Quard/7clock/hardware/7clock.kicad_pcb

## KiCad design hardware/7clock.kicad_pcb (2024-10-06)

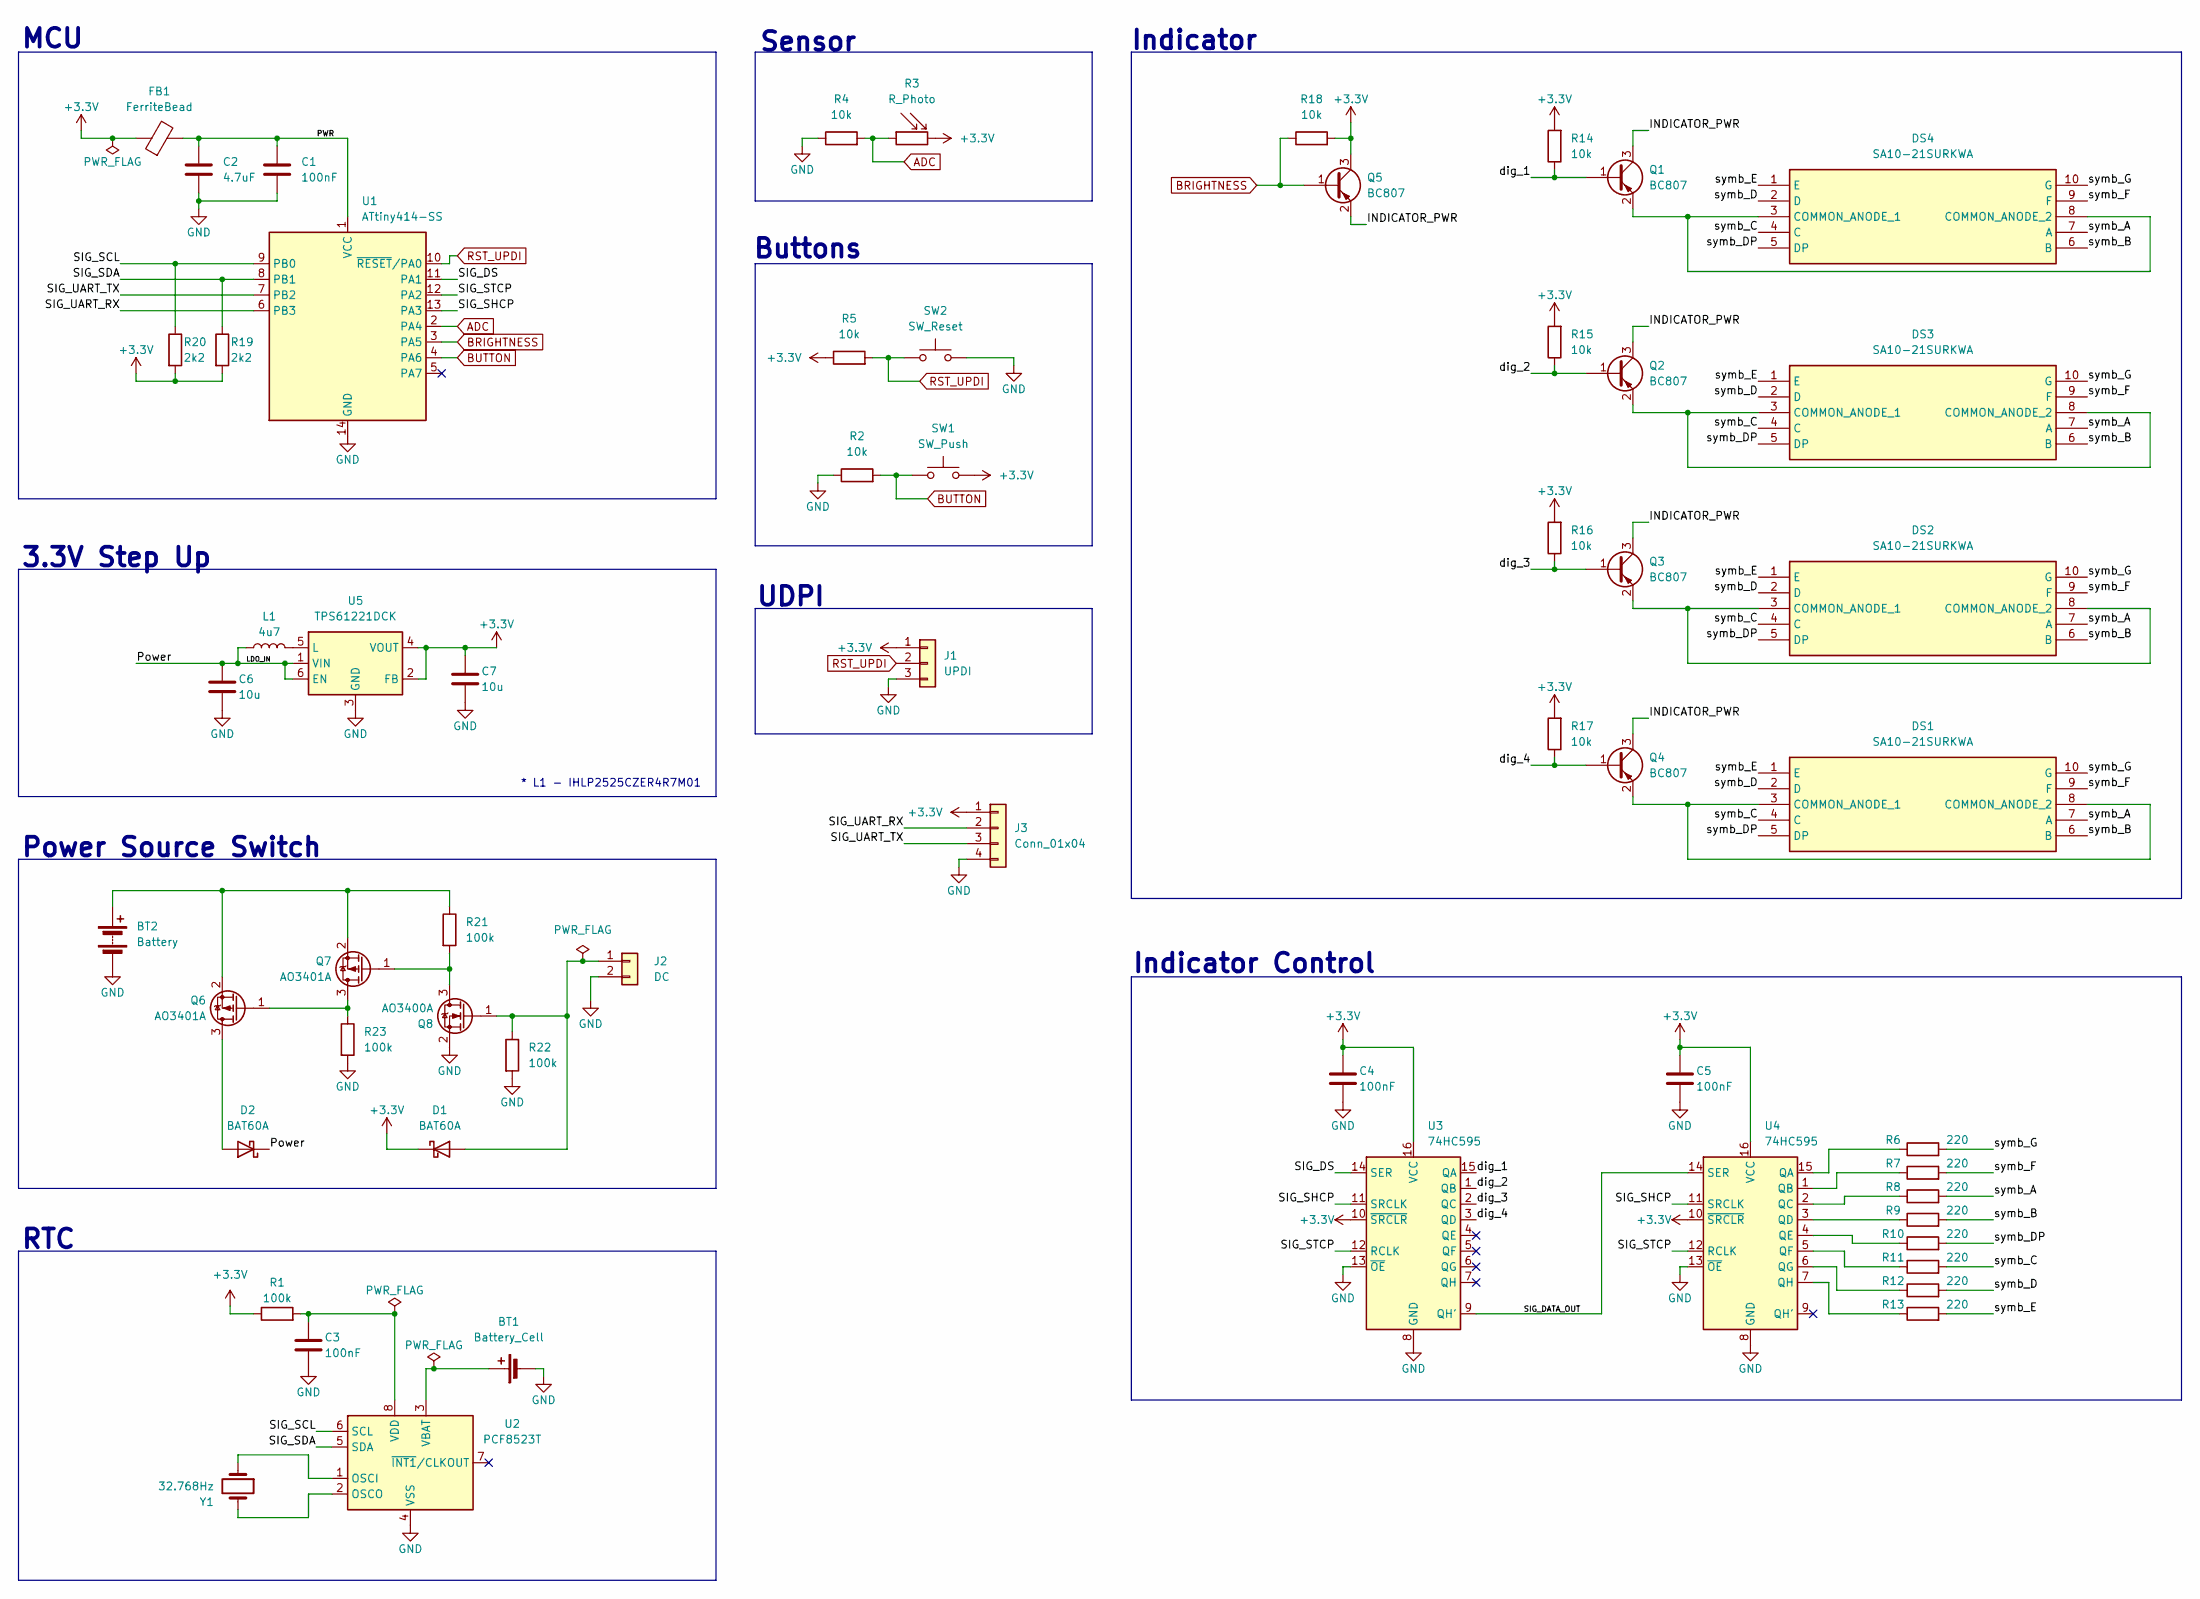
[picture p1: schematic 7clock.kicad_sch]

Parts:
BT1: Battery_Cell; CR1220D-011
BT2: Battery; PinHeader_1x02_P2.54mm_Vertical
C1, C3, C4, C5: 100nF; C_0603_1608Metric
C2: 4.7uF; C_0805_2012Metric
C6, C7: 10u; C_0805_2012Metric
D1, D2: BAT60A; D_SOD-323
DS1, DS2, DS3, DS4: SA10-21SURKWA; DIP3040W75P254L2400H1050Q10N; Manufacturer_Part_Number SA10-21SURKWA; Mouser Part Number 604-SA10-21SURKWA
FB1: FerriteBead; L_0603_1608Metric
J1: UPDI; PinHeader_1x03_P2.54mm_Vertical
J2: DC; PinHeader_1x02_P2.54mm_Vertical
J3: Conn_01x04; PinHeader_1x04_P2.54mm_Vertical
L1: 4u7; L_Vishay_IHLP-2525
Q1, Q2, Q3, Q4, Q5: BC807; SOT-23
Q6, Q7: AO3401A; SOT-23
Q8: AO3400A; SOT-23
R1, R21, R22, R23: 100k; R_0603_1608Metric
R2, R4, R5, R14, R15, R16, R17, R18: 10k; R_0603_1608Metric
R3: R_Photo; PinHeader_1x02_P2.54mm_Vertical
R6, R7, R8, R9, R10, R11, R12, R13: 220; R_0603_1608Metric
R19, R20: 2k2; R_0603_1608Metric
SW1: SW_Push; SW_SPST_SKQG_WithoutStem
SW2: SW_Reset; SW_SPST_CK_RS282G05A3
U1: ATtiny414-SS; SOIC-14_3.9x8.7mm_P1.27mm
U2: PCF8523T; SOIC-8_3.9x4.9mm_P1.27mm
U3, U4: 74HC595; SO-16_3.9x9.9mm_P1.27mm
U5: TPS61221DCK; Texas_R-PDSO-G6
Y1: 32.768Hz; Crystal_C38-LF_D3.0mm_L8.0mm_Horizontal

Connections:
+3.3V: C4.1, C5.1, C7.1, D1.1 (K), FB1.1, J1.1, J3.1, Q5.3 (C), R1.1, R3.2, R5.1, R14.2, R15.2, R16.2, R17.2, R18.2, R19.2, R20.2, SW1.2, U3.10 (~SRCLR), U3.16 (VCC), U4.10 (~SRCLR), U4.16 (VCC), U5.2 (FB), U5.4 (VOUT)
/INDICATOR_PWR: Q1.3 (C), Q2.3 (C), Q3.3 (C), Q4.3 (C), Q5.2 (E)
/LDO_IN: C6.1, D2.1 (K), L1.1, U5.1 (VIN), U5.6 (EN)
/PWR: C1.1, C2.1, FB1.2, U1.1 (VCC)
/SIG_DATA_OUT: U3.9 (QH'), U4.14 (SER)
/SIG_DS: U1.11 (PA1), U3.14 (SER)
/SIG_SCL: R20.1, U1.9 (PB0), U2.6 (SCL)
/SIG_SDA: R19.1, U1.8 (PB1), U2.5 (SDA)
/SIG_SHCP: U1.13 (PA3), U3.11 (SRCLK), U4.11 (SRCLK)
/SIG_STCP: U1.12 (PA2), U3.12 (RCLK), U4.12 (RCLK)
/SIG_UART_RX: J3.2, U1.6 (PB3)
/SIG_UART_TX: J3.3, U1.7 (PB2)
/dig_1: Q1.1 (B), R14.1, U3.15 (QA)
/dig_2: Q2.1 (B), R15.1, U3.1 (QB)
/dig_3: Q3.1 (B), R16.1, U3.2 (QC)
/dig_4: Q4.1 (B), R17.1, U3.3 (QD)
/symb_A: DS1.7 (A), DS2.7 (A), DS3.7 (A), DS4.7 (A), R8.2
/symb_B: DS1.6 (B), DS2.6 (B), DS3.6 (B), DS4.6 (B), R9.2
/symb_C: DS1.4 (C), DS2.4 (C), DS3.4 (C), DS4.4 (C), R11.2
/symb_D: DS1.2 (D), DS2.2 (D), DS3.2 (D), DS4.2 (D), R12.2
/symb_DP: DS1.5 (DP), DS2.5 (DP), DS3.5 (DP), DS4.5 (DP), R10.2
/symb_E: DS1.1 (E), DS2.1 (E), DS3.1 (E), DS4.1 (E), R13.2
/symb_F: DS1.9 (F), DS2.9 (F), DS3.9 (F), DS4.9 (F), R7.2
/symb_G: DS1.10 (G), DS2.10 (G), DS3.10 (G), DS4.10 (G), R6.2
ADC: R3.1, R4.2, U1.2 (PA4)
BRIGHTNESS: Q5.1 (B), R18.1, U1.3 (PA5)
BUTTON: R2.2, SW1.1, U1.4 (PA6)
GND: BT1.2 (-), BT2.2 (-), C1.2, C2.2, C3.2, C4.2, C5.2, C6.2, C7.2, J1.3, J2.2, J3.4, Q8.2 (S), R2.1, R4.1, R22.2, R23.2, SW2.2, U1.14 (GND), U2.4 (VSS), U3.8 (GND), U3.13 (~OE), U4.8 (GND), U4.13 (~OE), U5.3 (GND)
unnamed: BT1.1 (+), U2.3 (VBAT)
unnamed: BT2.1 (+), Q6.2 (S), Q7.2 (S), R21.1
unnamed: D1.2 (A), J2.1, Q8.1 (G), R22.1
unnamed: D2.2 (A), Q6.3 (D)
unnamed: DS1.3 (COMMON_ANODE_1), DS1.8 (COMMON_ANODE_2), Q4.2 (E)
unnamed: DS2.3 (COMMON_ANODE_1), DS2.8 (COMMON_ANODE_2), Q3.2 (E)
unnamed: DS3.3 (COMMON_ANODE_1), DS3.8 (COMMON_ANODE_2), Q2.2 (E)
unnamed: DS4.3 (COMMON_ANODE_1), DS4.8 (COMMON_ANODE_2), Q1.2 (E)
unnamed: Q6.1 (G), Q7.3 (D), R23.1
unnamed: Q7.1 (G), Q8.3 (D), R21.2
unnamed: U2.1 (OSCI), Y1.1
unnamed: U2.2 (OSCO), Y1.2
unnamed: C3.1, R1.2, U2.8 (VDD)
unnamed: R6.1, U4.15 (QA)
unnamed: R7.1, U4.1 (QB)
unnamed: R8.1, U4.2 (QC)
unnamed: R9.1, U4.3 (QD)
unnamed: R10.1, U4.4 (QE)
unnamed: R11.1, U4.5 (QF)
unnamed: R12.1, U4.6 (QG)
unnamed: R13.1, U4.7 (QH)
unnamed: L1.2, U5.5 (L)
RST_UPDI: J1.2, R5.2, SW2.1, U1.10 (~RESET/PA0)

Notes on the sheet:
Indicator Control
MCU
Indicator
Power Source Switch
* L1 - IHLP2525CZER4R7M01
3.3V Step Up
Sensor
RTC
UDPI
Buttons

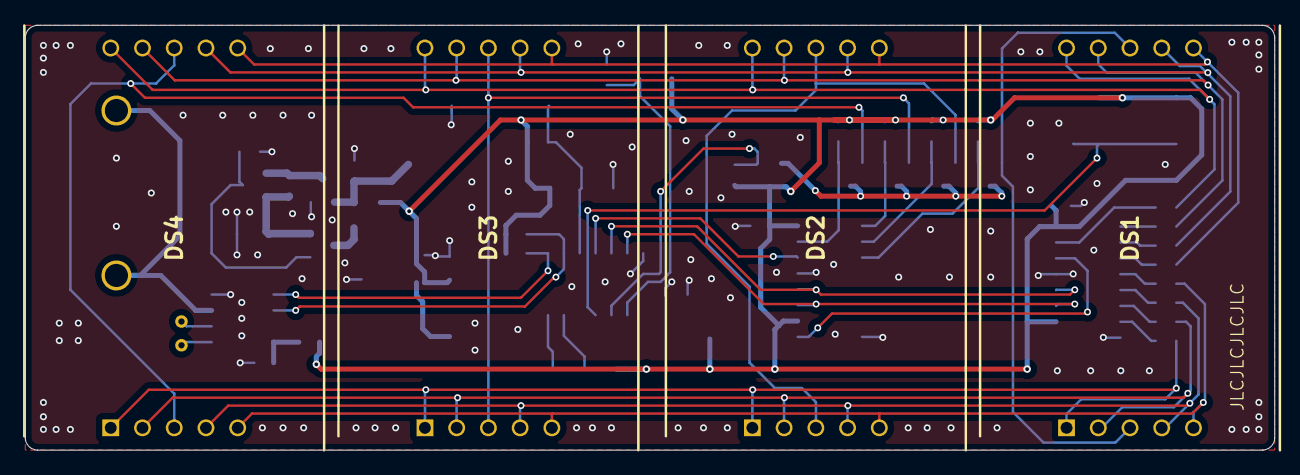
[picture p2: board 7clock.kicad_pcb from above]

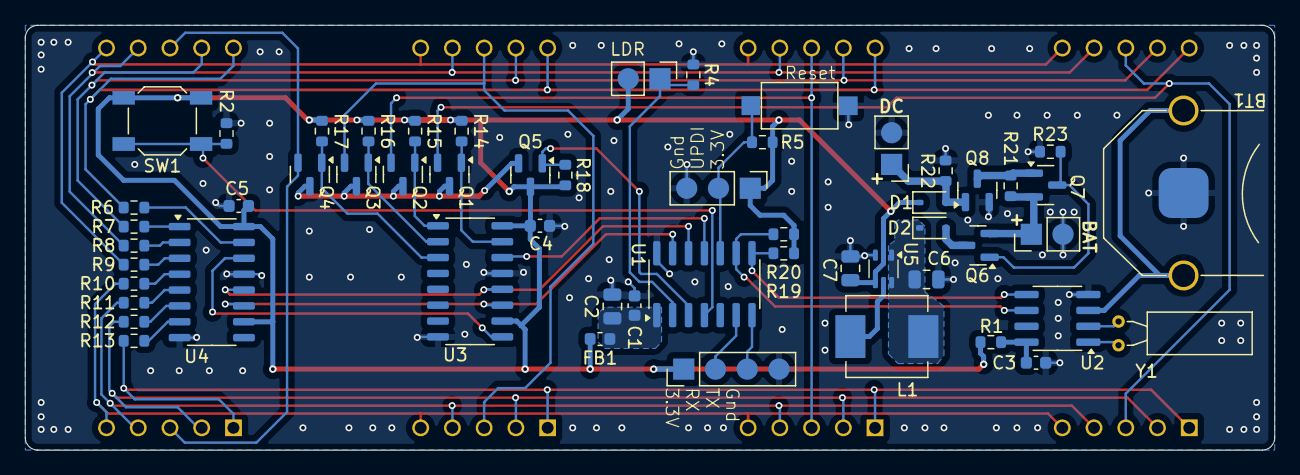
[picture p3: board 7clock.kicad_pcb from below]

Board: 2 copper layers, 100.0 x 34.0 mm, 59 parts (55 on the bottom side), 51 nets.
