Quard/7clock/(commit log)

2023-02-01 pic configuration and simple display driver
2023-02-01 control brightness using ldr sensor
2023-02-03 use interrupt for timer1 and spi
2023-02-03 use button to control min brightness
2023-02-04 state machine to setup clock via one button
2023-02-04 fix timer1 freq
2024-06-29 fix button according to the schematic
    [main.c]
2024-09-12 WIP schematic and pcb for avr version
    [7clock-CmtUser.gbr, 7clock-CuBottom.gbl, 7clock-CuTop.gtl, 7clock-EdgeCuts.gm1, 7clock-MaskBottom.gbs, 7clock-MaskTop.gts, 7clock-PasteBottom.gbp, 7clock-PasteTop.gtp]
2024-09-13 WIP avr processing button and additional timer like systick
2024-09-13 avr fix showing clock after setup the time
    [device.h, main.c, state.c]
